Nabilphysics/opensim/images/opensim_pipeline.png

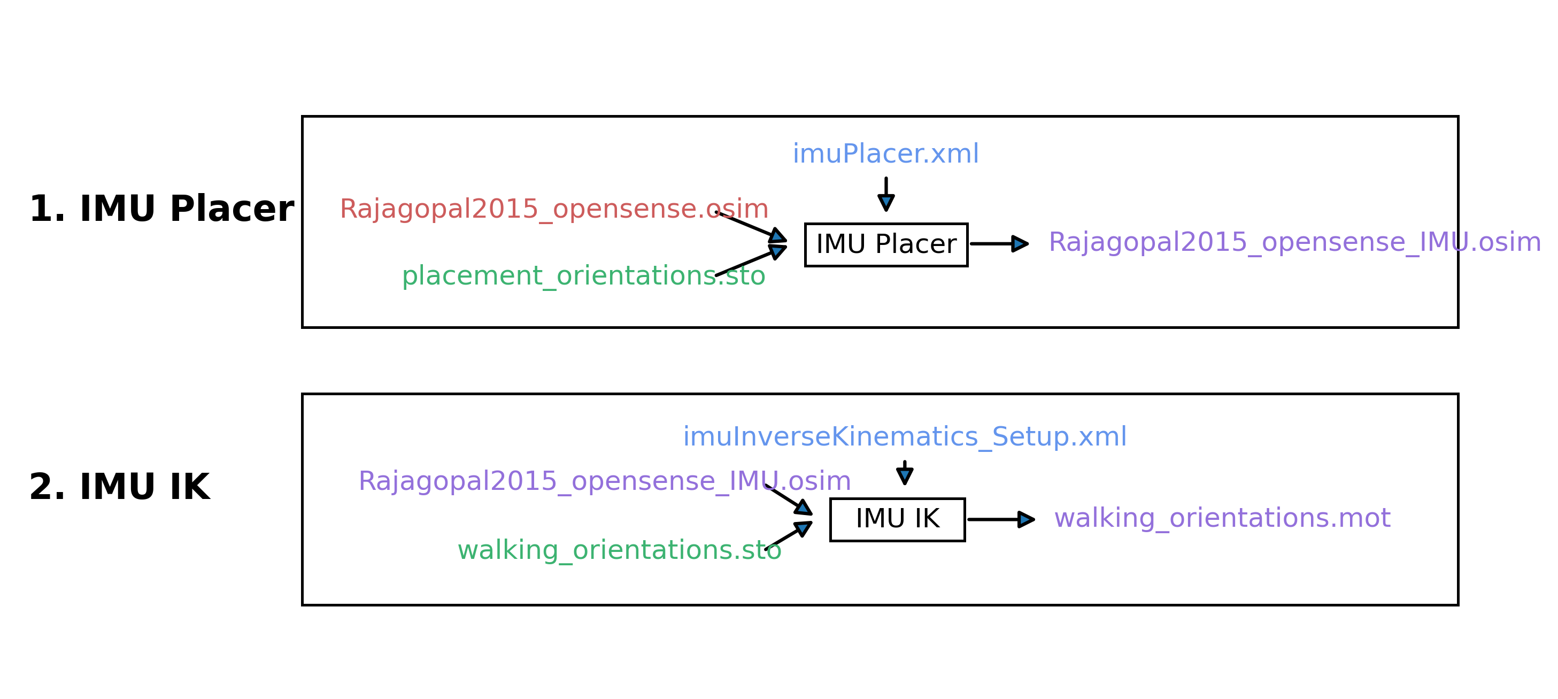
images/opensim_pipeline.png
